lostclus/LowcostRC/Documentation/Images/Receiver_ESP8266_Side_A.jpg

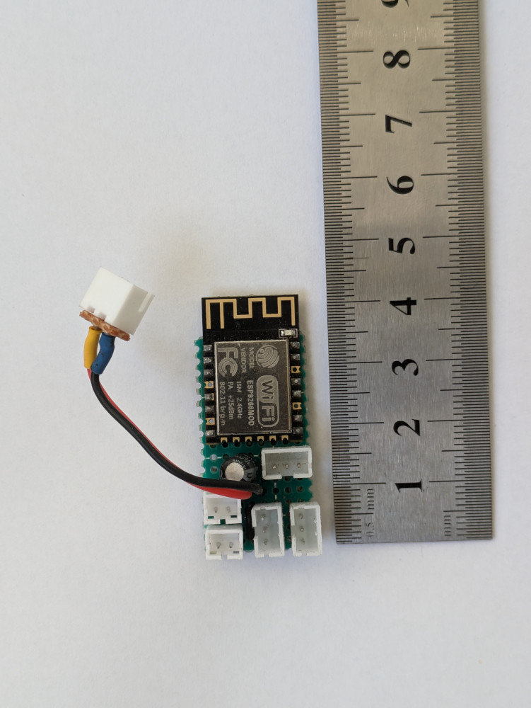
Documentation/Images/Receiver_ESP8266_Side_A.jpg
