lostclus/LowcostRC/Documentation/Images/Receiver_ESP8266_Side_B.jpg

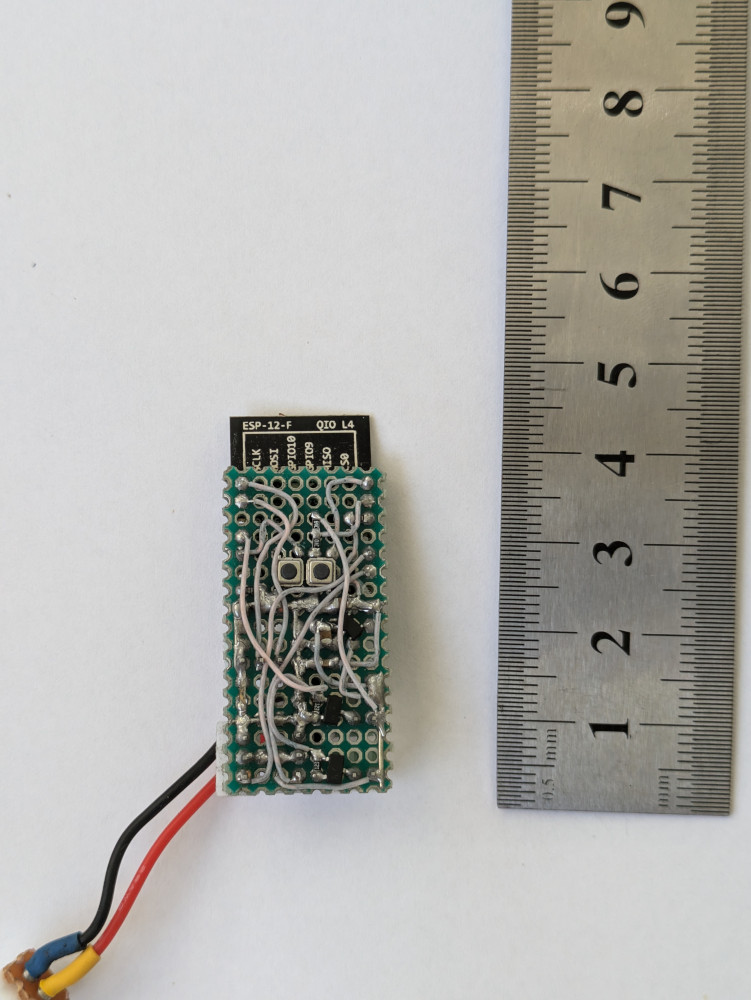
Documentation/Images/Receiver_ESP8266_Side_B.jpg
