lostclus/LowcostRC/Documentation/Images/Transmitter_with_ESP8266.jpg

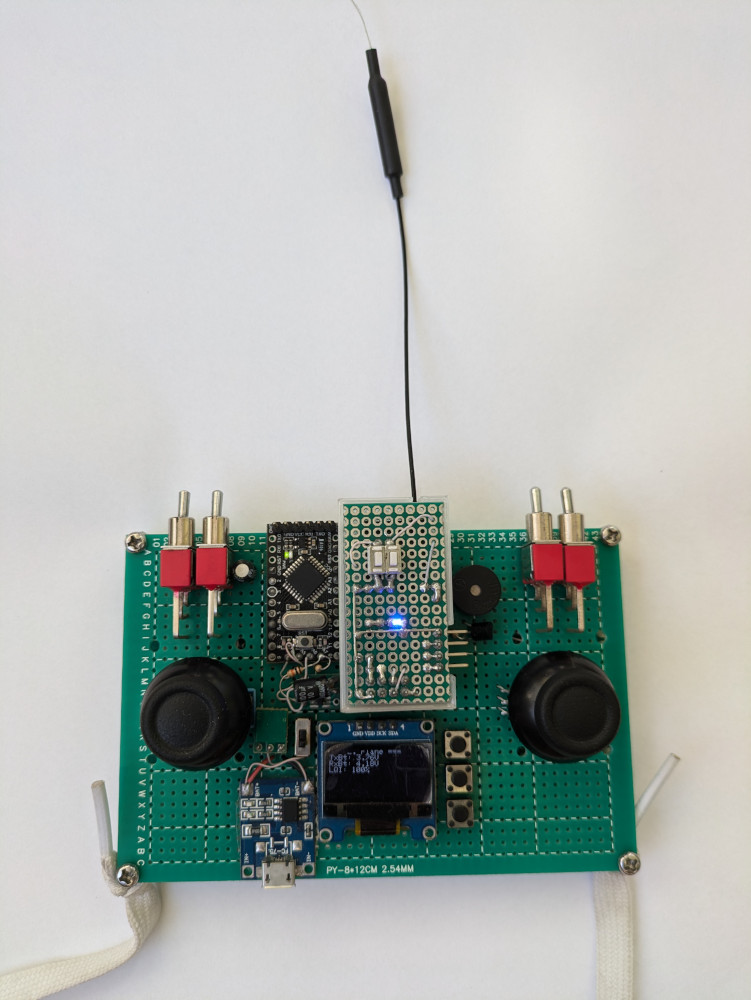
Documentation/Images/Transmitter_with_ESP8266.jpg
