lostclus/LowcostRC/Documentation/Schematics/Receiver_ESP8266_for_1S_brushed_plane.pdf

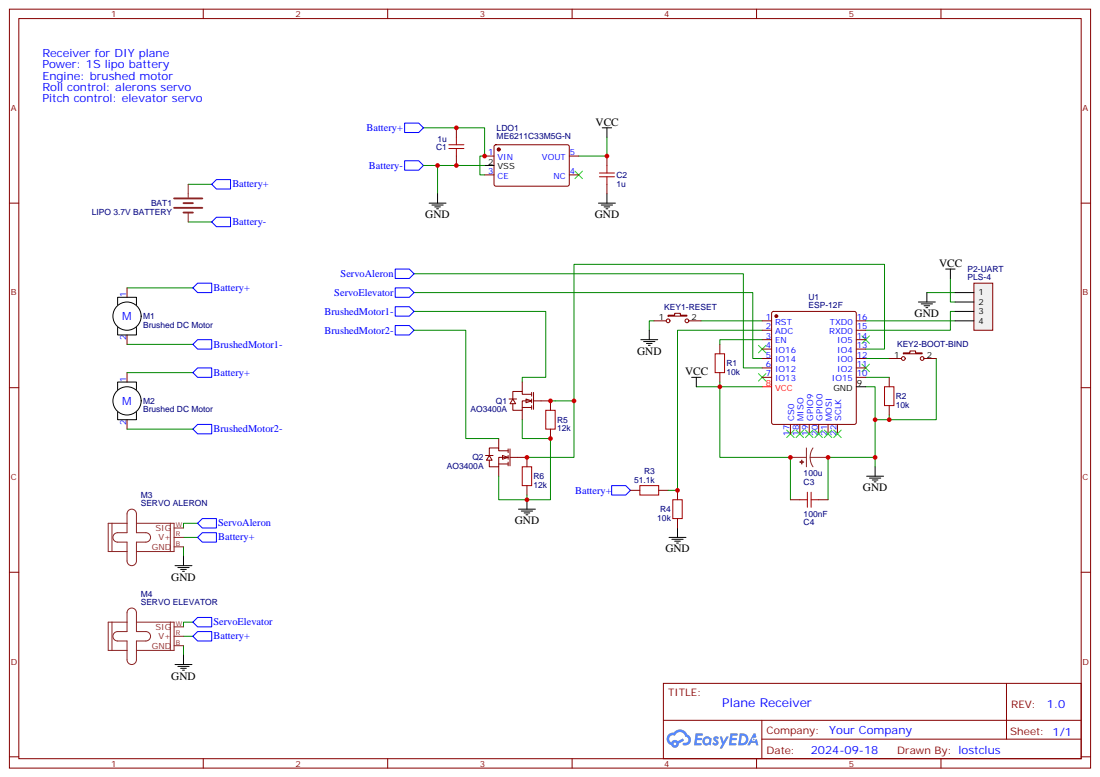
[picture p5: page 1]

Receiver for DIY plane
Power: 1S lipo battery
Engine: brushed motor
Roll control: alerons servo
Pitch control: elevator servo
