lostclus/LowcostRC/Documentation/Schematics/Receiver_nRF24L01_for_2S_brushless_plane.pdf

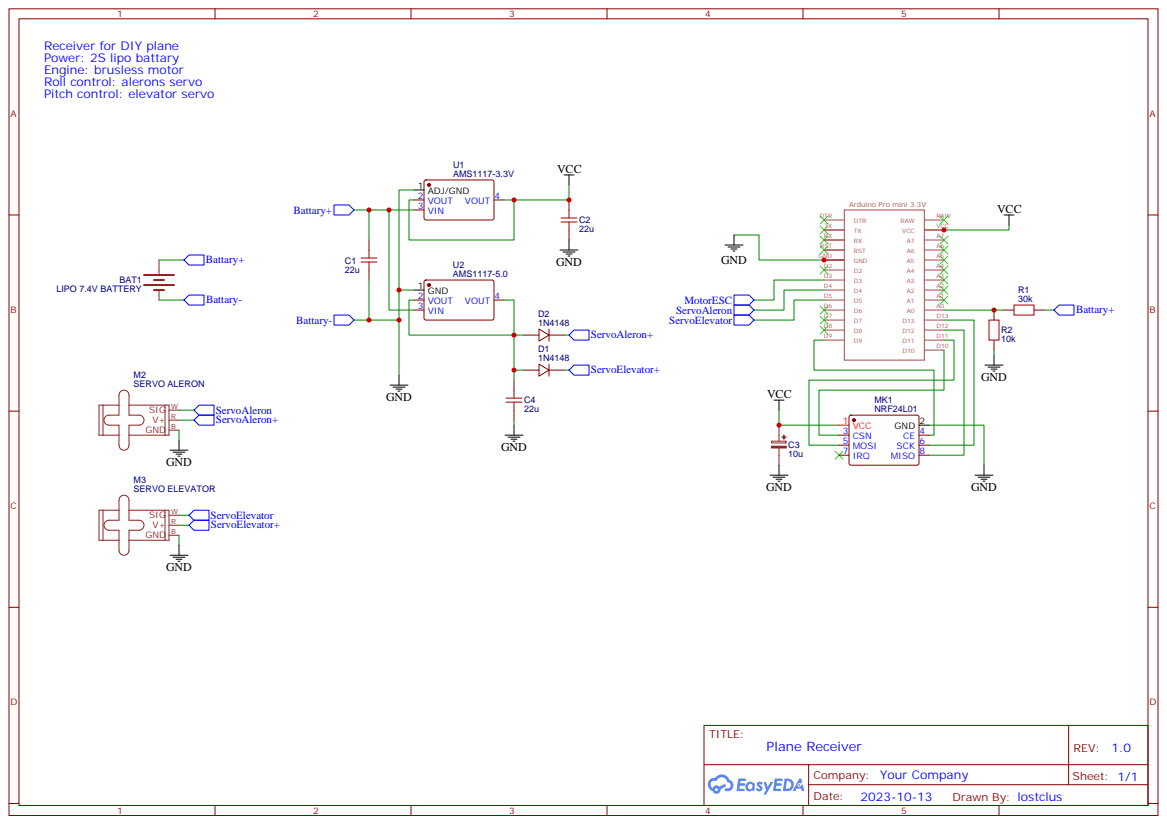
[picture p6: page 1]

Receiver for DIY plane
Power: 2S lipo battary
Engine: brusless motor
Roll control: alerons servo
Pitch control: elevator servo
