lostclus/LowcostRC/Documentation/Schematics/Receiver_nRF24L01_for_1S_brushed_plane.pdf

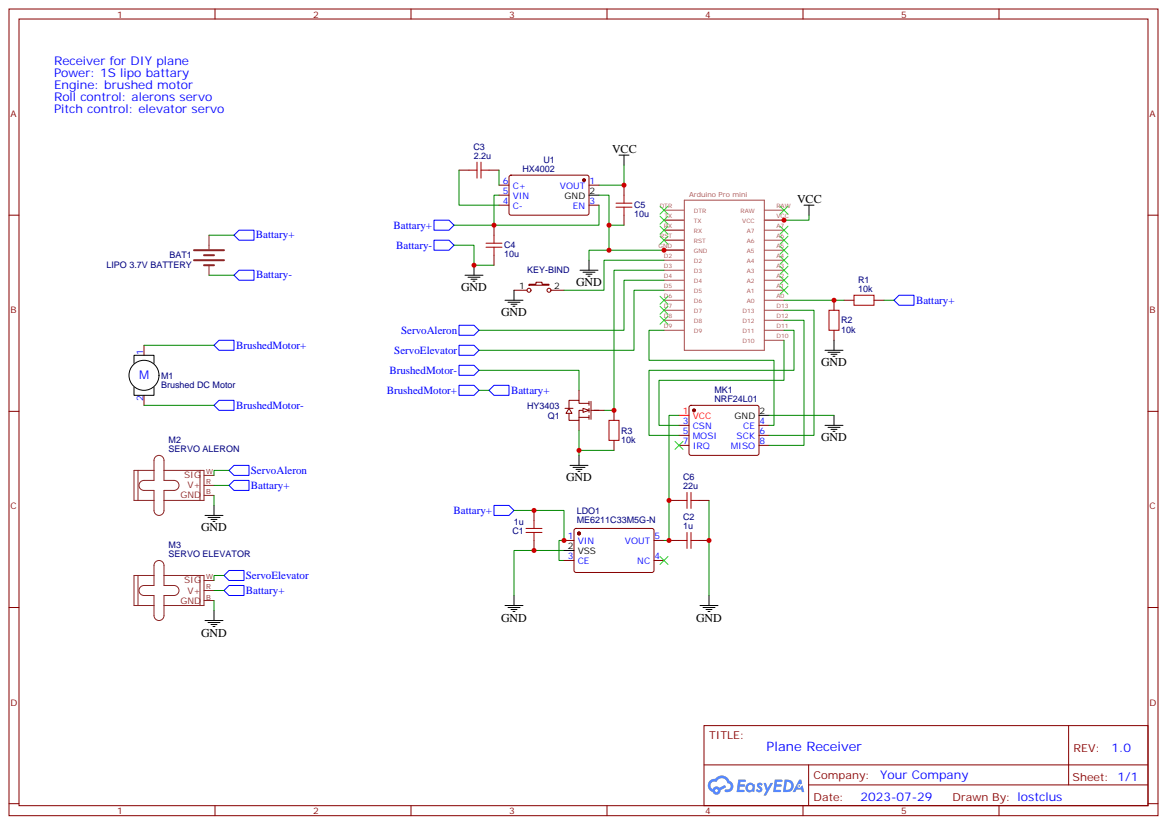
[picture p7: page 1]

Receiver for DIY plane
Power: 1S lipo battary
Engine: brushed motor
Roll control: alerons servo
Pitch control: elevator servo
