lostclus/LowcostRC/Documentation/Schematics/Receiver_for_simulator.pdf

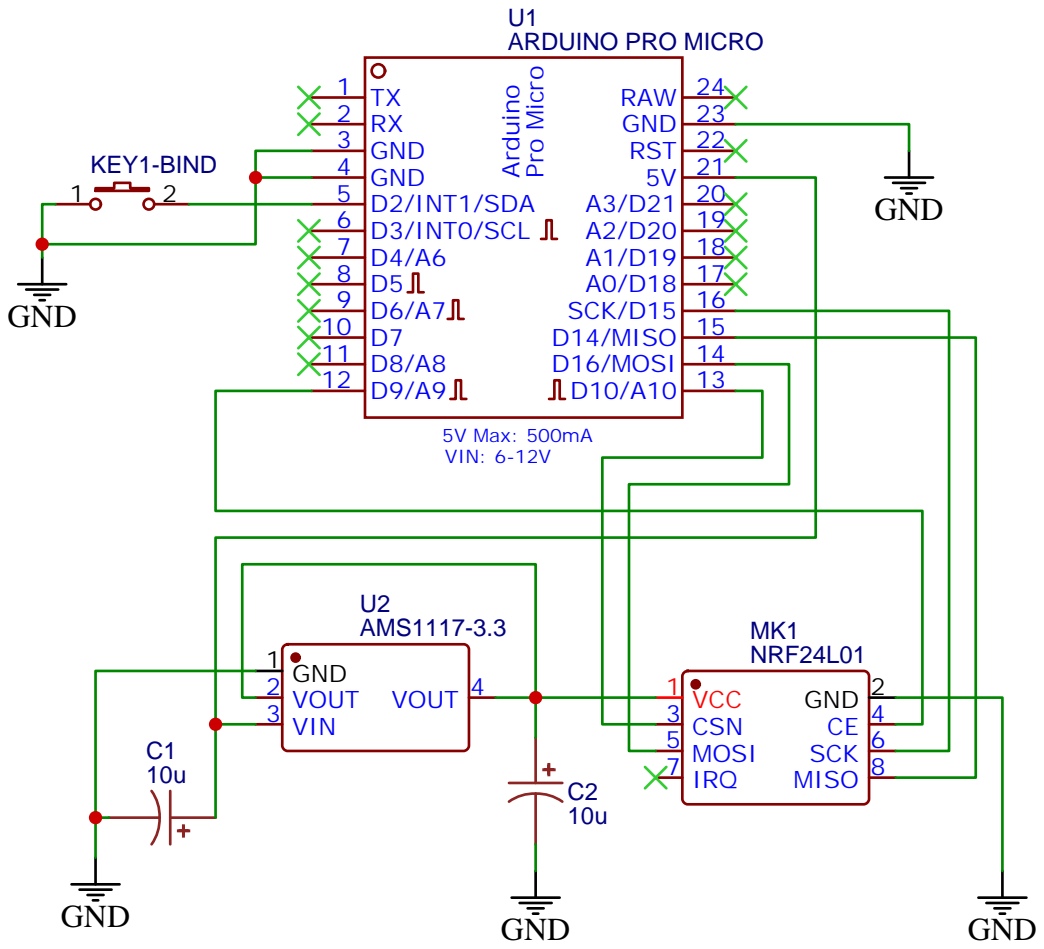
[picture p8: page 1]
