lostclus/LowcostRC/Documentation/Schematics/Transmitter.pdf

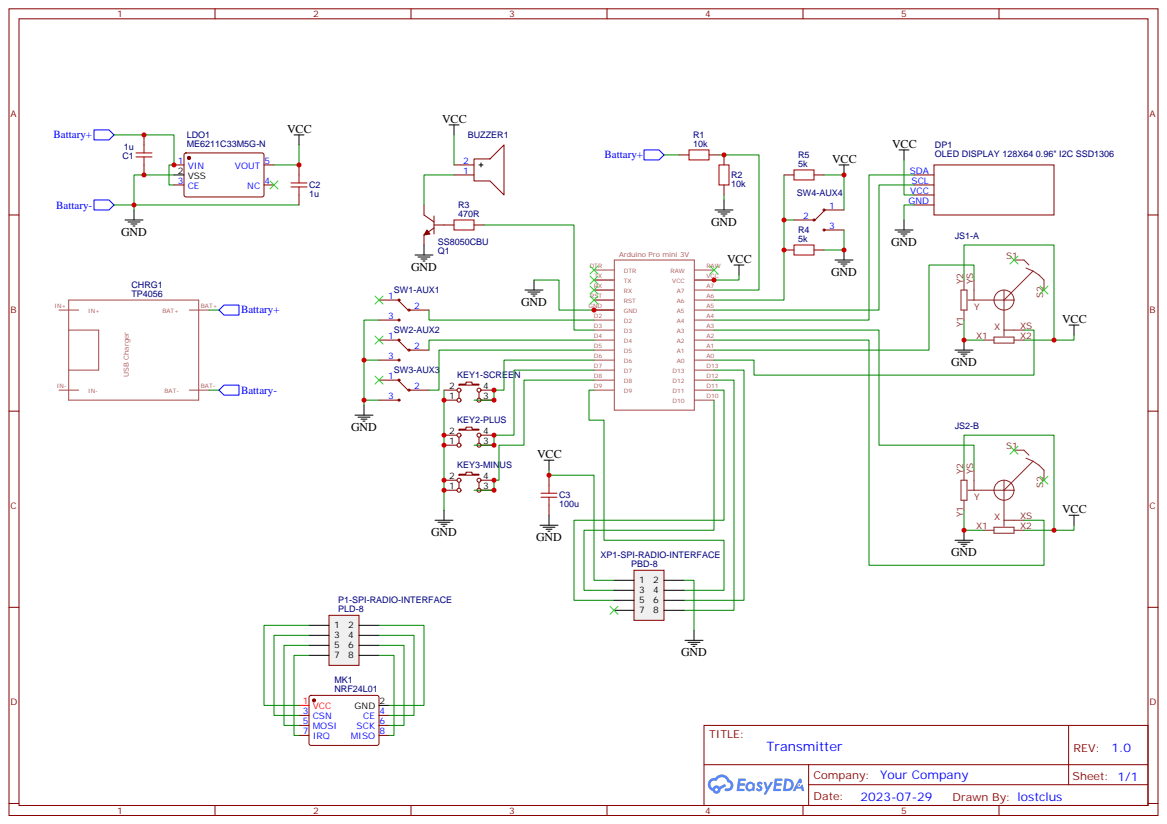
[picture p9: page 1]
