lostclus/LowcostRC/Documentation/Schematics/Transmitter_Radio_ESP8266.pdf

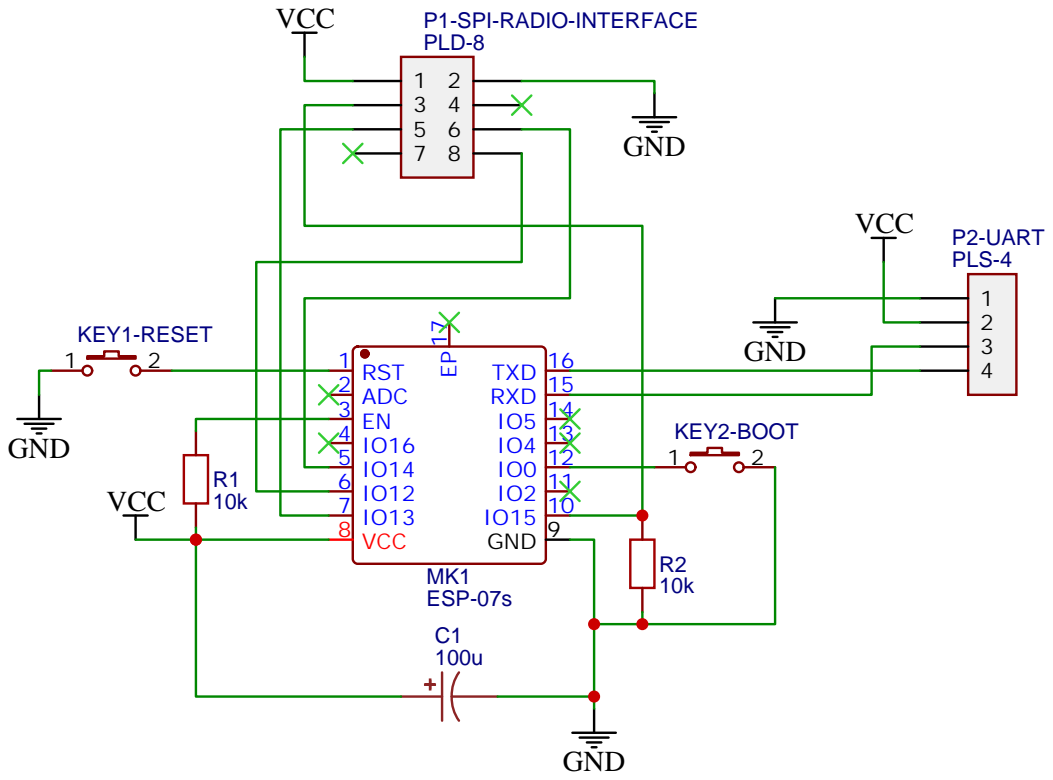
[picture p10: page 1]
