lostclus/LowcostRC/Transmitter/Config.h

#ifndef Config_h
#define Config_h

#define BUZZER_PIN          3

#define JOYSTICK_PINS       {A1, A0, A3, A2}
#define SWITCH_PINS         {2, 4, 5, A6}
#define IS_ANALOG_SWITCH(n) (n == SWITCH_4)

#define VOLT_METER_PIN      A7
#define VOLT_METER_R1       10000L
#define VOLT_METER_R2       10000L

#define RANDOM_SEED_PIN     A4

#if !defined(WITH_RADIO_NRF24) && !defined(WITH_RADIO_SPI)
#define WITH_RADIO_NRF24
#define WITH_RADIO_SPI
#endif

#define RADIO_NRF24_CE_PIN  9
#define RADIO_NRF24_CSN_PIN 10

#define DISPLAY_WIDTH       128
#define DISPLAY_HEIGHT      64
#define DISPLAY_ADDRESS     0x3C

#if !defined(WITH_ADAFRUIT_SSD1306) && !defined(WITH_SSD1306_ASCII)
#define WITH_SSD1306_ASCII
#endif

#define KEY_SCREEN_PIN      6
#define KEY_PLUS_PIN        7
#define KEY_MINUS_PIN       8

#define MIN_LINK_QUALITY    5
#define BATTERY_MONITOR_INTERVAL 5000
#define SCREEN_DISPLAY_REDRAW_INTERVAL 1000

//undef FLAT_MENU

#endif // Config_h
