lostclus/LowcostRC/Transmitter/Types.h

#ifndef Types_h
#define Types_h

enum Axis {
  AXIS_A_X,
  AXIS_A_Y,
  AXIS_B_X,
  AXIS_B_Y,
  AXES_COUNT,
};

enum Switch {
  SWITCH_1,
  SWITCH_2,
  SWITCH_3,
  SWITCH_4,
  SWITCHES_COUNT,
};

#endif // Types_h
// vim:et:sw=2:ai
