lostclus/LowcostRC/(commit log)

2023-12-23 Add switches. Add channel 5 and 6. Add low and high beep tone.
2023-12-26 No alarm on zero battary voltage. Change beep duration.
2024-02-17 Implement channals switching in ESP8266 radio.
2024-02-20 Update retry interval on Tx error. More log messages.
    [Controls.cpp]
2024-02-27 More debug. Some fixes.
    [Radio_NRF24.cpp, Receiver_1S.ino, Receiver_2S.ino]
2024-09-12 Rename "no link" to "failsafe"
    [Receiver_1S.ino, Receiver_2S.ino, Receiver_Sim.ino]
2024-09-12 Implement failsafe in Receiver_ESP8266
    [Receiver_ESP8266.ino]
2024-09-14 Fix retries in NRF24RadioModule
    [Radio_NRF24.cpp]
2024-09-15 Rename buttons in transmitter
2024-09-17 Add schematics
2024-09-17 Update schematics
2024-09-18 Add Documentation/Schematics/Receiver_for_simulator.pdf
2024-09-20 Implement outputs. Add volt metter class
2024-09-24 Fix volt metter
